hhtronik/qok-i-learn-soldering-smd/schematic.pdf

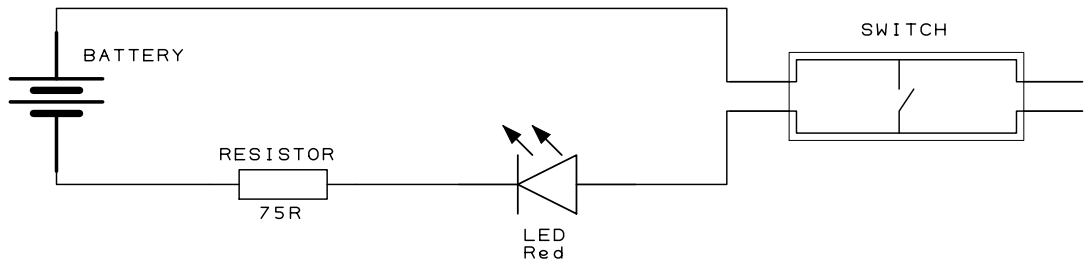
[picture p4: page 1]
