hhtronik/qok-i-learn-soldering-smd/(list of files, drawings)

Other design files:
designspark/hhtqok-ils-smd.pcb
