hhtronik/qok-i-learn-soldering-smd/(commit log)

2020-03-31 Added a rendering of the pcb
2020-03-31 Improved paragraph about current limiting resistor
2020-03-31 Added assembly instructions and troubleshooting info
2020-04-30 Updated the pcb renderings
2020-04-30 Started the soldering guide
2020-06-19 Added instructions about soldering the LED, switch and battery clip to soldering-instructions.md
2020-06-24 Fixed path to image in soldering-instructions.md
